dbergl/rv-level-sensor/docs/superpowers/plans/2026-11-01-ac-bridge.md

# AC Bridge Implementation Plan

> **For agentic workers:** REQUIRED SUB-SKILL: Use superpowers:subagent-driven-development (recommended) or superpowers:executing-plans to implement this plan task-by-task. Steps use checkbox (`- [ ]`) syntax for tracking.

**Goal:** The ESP32 leveling sensor also becomes the Firefly panel's RV-C AC (instance 7), bridging to the CountryModPro rooftop unit over Bluetooth, with paired Home Assistant control through the `rv_level` integration.

**Architecture:** Host-testable logic in `lib/` (unit protocol, bridge state machine, RV-C thermostat codec and panel glue, pairing/session crypto, HA message codec), thin NimBLE glue in `src/hal/`, wiring in `src/main.cpp` behind two build options. On the HA side, `rv_level` gains a second config-entry kind ("ac") with its own Bluetooth client and the full `countrymodpro` entity set.

**Tech Stack:** ESP32 Arduino + PlatformIO, NimBLE-Arduino 1.4, Unity host tests (`pio test -e native`), monocypher 4.0.2 (already in `lib/`); Home Assistant custom integration (Python 3.14, bleak / bleak-retry-connector via HA's bluetooth, `cryptography`, `hashlib.blake2b`), pytest-homeassistant-custom-component.

**Spec:** `docs/superpowers/specs/2026-11-01-ac-bridge-design.md` (read its Signal sheet before any task; it is the only source of wire facts).

## Global Constraints

- **Clean room:** do not open `countrypro/`, `velit-hass`, `countrymodpro` or the Pi bridge sources. Every byte value comes from the spec's Signal sheet.
- Unit commands are limited to the spec's allow-list; nothing else may ever be written to the unit.
- At least 400 ms between unit commands; a command with no status frame within 3 s has failed.
- Instance 7. Panel status DGNs sent: 1FFE2, 1FF9C, 1FEFA, 0FFA1 (priority 6), on change and at least every 5 s; never 1FFE1.
- Temperatures on RV-C: uint16 LE, 1/32 °C/bit, offset −273 °C, encoded by rounding **up**.
- Setpoint 61–86 °F, whole degrees; refused while the unit is in °C.
- With the AC bridge on, CPU runs at 240 MHz all the time; AC-off builds keep today's 80 MHz behavior.
- AC-off build behaves exactly as today (all existing tests pass unchanged).
- Both build options off must fail to compile.
- HA entity ids and values match today's `countrymodpro` set (spec entity table), except fresh air and dehumid, which are dropped.
- Code style follows this repo (namespaces per lib, `camelCase` methods, trailing-underscore members, terse comments that say why).

## Review Focus

1. **The unit changes on its own mid-command** (someone uses its remote): the reply shows something else. Expected: the reply is the truth, the intent is reported failed if not satisfied, nothing is retried in a loop. Test in Task 3.
2. **Fragment loss or garbage between frames**: expected resync on the next `5A 5A`, no wedged stream, no false frame. Test in Task 2.
3. **A captured HA command is replayed**, in the same or a later connection: expected rejected. Test in Task 6.
4. **Panel commands while the unit is unreachable**: expected nothing queued; after reconnect nothing old is sent, and the panel stays stale. Test in Tasks 3 and 5.
5. **Setpoint up at 86 °F, down at 61 °F, or heat/dry/unknown panel codes**: expected no command outside 61–86 and no heat/dry command. Test in Task 5.

---

### Task 1: Build options, `countrypro/` ignored, Node without leveling

**Files:**
- Modify: `.gitignore`, `platformio.ini`, `src/config.h`, `src/main.cpp`, `lib/rvc/node.h`, `lib/rvc/node.cpp`
- Test: `test/test_node/test_main.cpp`

**Interfaces:**
- Produces: macros `RVL_LEVELING` and `RVL_AC_BRIDGE` (0/1, default 1), mirrored as `cfg::LEVELING_ENABLED` / `cfg::AC_BRIDGE_ENABLED` (`constexpr bool`); `rvc::NodeConfig::leveling` (`bool`, default `true`); PlatformIO envs `esp32` (both), `esp32_level` (leveling only), `esp32_ac` (AC only).

- [ ] **Step 1:** Add `countrypro/` to `.gitignore`; confirm `git status --short` no longer lists it.
- [ ] **Step 2: Write the failing tests** in `test/test_node/test_main.cpp`:
  - `test_no_leveling_claims_and_answers_product_id`: `NodeConfig c = config(); c.leveling = false;` claim, then a REQUEST for PRODUCT_ID gets the multipacket reply (same assertions as the existing PRODUCT_ID test).
  - `test_no_leveling_sends_no_leveling_dgns`: after claim and 5 s of `update(SensorSnapshot{}, t)` every 10 ms, `bus.count(dgn::LEVELING_SENSOR_STATUS) == 0`, `bus.count(dgn::LEVEL_WHEEL_STATUS) == 0`, `bus.count(dgn::PITCH_CONFIG_STATUS) == 0`, and DM_RV frames exist with no fault (byte 0 lamp bits clear).
  - `test_no_leveling_ignores_config_and_block_commands`: a PITCH_CONFIG_COMMAND and a block config command produce no ACK/NAK and no status.
- [ ] **Step 3:** Run `pio test -e native -f test_node`; expect the three new tests to fail.
- [ ] **Step 4:** Add `bool leveling = true;` to `NodeConfig`. When false, `Node::update` skips status, config-status and wheel sends and reports DM_RV with no fault; `onFrame` skips PROPRIETARY_A2 and pitch/roll config commands; `handleRequest` NAKs leveling DGNs as unknown.
- [ ] **Step 5:** Run `pio test -e native`; expect all tests to pass (existing ones unchanged).
- [ ] **Step 6:** In `src/config.h` add the `#ifndef RVL_LEVELING / #define RVL_LEVELING 1` pair (and `RVL_AC_BRIDGE`), the two `constexpr bool`s, `static_assert(LEVELING_ENABLED || AC_BRIDGE_ENABLED, "enable leveling, the AC bridge, or both")`, and `MODEL` chosen by build: `LEVEL-MPU6050` (leveling only), `AC-COUNTRYMOD` (AC only), `LEVEL-AC` (both). In `platformio.ini` add `esp32_level` (`-DRVL_AC_BRIDGE=0`) and `esp32_ac` (`-DRVL_LEVELING=0`) extending `env:esp32`. In `src/main.cpp` gate MPU init, sampling, `bleReading` and LED out-of-level on `cfg::LEVELING_ENABLED`, and pass `nc.leveling = cfg::LEVELING_ENABLED`.
- [ ] **Step 7:** Run `pio run -e esp32 && pio run -e esp32_level && pio run -e esp32_ac`; all three build. Temporarily build with `-DRVL_LEVELING=0 -DRVL_AC_BRIDGE=0` and confirm the static_assert message, then revert.
- [ ] **Step 8:** Commit: `feat: build options for leveling and the AC bridge`.

---

### Task 2: CountryModPro unit protocol (`lib/countrymod`)

**Files:**
- Create: `lib/countrymod/unit_protocol.h`, `lib/countrymod/unit_protocol.cpp`
- Test: `test/test_unit_protocol/test_main.cpp`

**Interfaces:**
- Produces (namespace `cm`):
  - `constexpr size_t kCommandLen = 9; constexpr size_t kFrameLen = 21;`
  - `bool isAllowed(uint8_t func, uint8_t data);`
  - `bool buildCommand(uint8_t func, uint8_t data, uint8_t out[kCommandLen]);` — false (and `out` untouched) if not allowed.
  - `class FrameAssembler { public: template<class F> void feed(const uint8_t* d, size_t n, F onFrame); uint32_t discarded() const; };` — calls `onFrame(const uint8_t frame[kFrameLen])` for each valid frame.
  - `enum class Mode : uint8_t { Cool, Eco, Sleep, Turbo, FanOnly, Dehumid, Unknown };`
  - `struct UnitStatus { bool power; bool display; bool light; bool oscillating; bool celsius; uint8_t fan; /*0 auto,1-5, 0xFF unknown*/ Mode mode; uint8_t setpointF; /*0xFF unknown*/ uint8_t airTempF; /*0xFF unknown*/ uint8_t setpointRaw; uint8_t batteryV; /*0xFF unknown*/ uint16_t lvpDeciV; uint8_t raw[kFrameLen]; };`
  - `bool decodeStatus(const uint8_t frame[kFrameLen], UnitStatus& out);` — false if checksum/framing bad.
  - `constexpr uint8_t` names for every func and data value in the allow-list (`kFuncPower = 0x01`, `kPowerOn = 0x02`, `kModeCool = 0x01`, … `kFanAuto = 0x06`).

- [ ] **Step 1: Write the failing tests:**
  - `test_build_command_power_on`: `buildCommand(0x01, 0x02, out)` → `5A 5A 06 01 01 02 <ck> 0D 0A` with `ck = (0x5A+0x5A+0x06+0x01+0x01+0x02) & 0xFF = 0xBE`.
  - `test_allow_list`: true for every row of the spec's command table (loop over all listed values, including 61 and 86 setpoints); false for mode `03`, mode `07`, func `44`, setpoint 60 and 87, fan 0 and 7, func `0B`.
  - `test_build_refuses_disallowed`: returns false and leaves `out` unchanged.
  - `test_assembler_10_10_1`: a valid frame fed as 10, 10, 1 bytes yields exactly one frame.
  - `test_assembler_resyncs_after_garbage_and_lost_fragment` (Review Focus 2): feed `FF 00 5A`, then a frame missing its middle 10 bytes, then a full valid frame → exactly one frame (the last), `discarded() > 0`.
  - `test_assembler_split_header`: a frame whose `5A 5A` header is split across two feeds is found.
  - `test_assembler_bad_checksum_rejected`.
  - `test_decode_fields`: build frames from the spec's field table and assert power, display, fan (`(b2>>1)&7`), light, oscillating, celsius (`b16 == 0`), battery (`b8`), `lvpDeciV == 256 + b9`.
  - `test_decode_mode`: b3 `0x10/0x20/0x80` → Sleep/Eco/Turbo; b3 `0x00` with b2 bits `0x30` → FanOnly, `0x20` → Dehumid, `0x00` → Cool; b3 `0x40` (vendor app) treated as `0x00`; b3 `0x30` → Unknown.
  - `test_decode_out_of_range_unknown`: air temp 29 and 131 °F, setpoint 49 and 100 °F, battery 19 and 71 → `0xFF`.
  - `test_decode_celsius_converts`: b16 = 0, b4 = 14, b17 = 18 → `airTempF == 57`, `setpointF == 64`, `setpointRaw == 18`.
- [ ] **Step 2:** Run `pio test -e native -f test_unit_protocol`; fails to compile.
- [ ] **Step 3:** Implement per the signatures (°C → °F is `round(c * 9 / 5 + 32)`).
- [ ] **Step 4:** Run the tests; all pass.
- [ ] **Step 5:** Commit: `feat(ac): CountryModPro unit protocol`.

---

### Task 3: Bridge state machine (`lib/acbridge`)

**Files:**
- Create: `lib/acbridge/bridge.h`, `lib/acbridge/bridge.cpp`
- Test: `test/test_bridge/test_main.cpp`

**Interfaces:**
- Consumes: `cm::buildCommand`, `cm::FrameAssembler`, `cm::decodeStatus`, `cm::UnitStatus`, `cm::Mode` (Task 2).
- Produces (namespace `ac`):
  - `class IUnitLink { public: virtual bool connected() const = 0; virtual bool write(const uint8_t* d, size_t n) = 0; };`
  - `enum class Op : uint8_t { Power, Mode, Fan, Setpoint, StepSetpoint, Display, Oscillate, Light, Celsius };`
  - `struct Intent { Op op; int8_t value; uint32_t tag; };` — `Mode` values are `cm::Mode` (Cool, Eco, Sleep, Turbo, FanOnly only); `Fan` 0 = auto, 1–5; `Setpoint` °F; `StepSetpoint` ±1; bools as 0/1; `tag` is echoed in the result.
  - `enum class Result : uint8_t { Ok = 0, Refused = 1, Unreachable = 2, NotConfirmed = 3, BadAuth = 4 };` (`BadAuth` is used only by Task 9)
  - `class Bridge { public: explicit Bridge(IUnitLink& link); void submit(const Intent& i, uint32_t nowMs); void onNotify(const uint8_t* d, size_t n, uint32_t nowMs); void tick(uint32_t nowMs); bool responding(uint32_t nowMs) const; const cm::UnitStatus& status() const; uint32_t statusVersion() const; bool takeResult(uint32_t& tag, Result& r); };`
  - Constants: `kGapMs = 400`, `kTimeoutMs = 3000`, `kPollMs = 3000`, `kRespondingMs = 10000`, `kMaxPending = 8`.

Behavior (the decisions the tests pin):
- One intent at a time, FIFO, up to `kMaxPending` (submit beyond that → `Refused`). Each intent expands to an ordered command list from the current status; the intent succeeds when the last command's reply status satisfies it, else `NotConfirmed`.
- Expansion: `Power 0` → `01 01`; `Power 1` → `01 02`. `Mode Cool` → `01 02` if off, then `02 01` unless already Cool/Eco/Sleep/Turbo (then no-op `Ok`). `Mode FanOnly` → power on if off, `02 02`. `Mode Eco/Sleep/Turbo` → `Refused` if off; else `02 04/05/06`. `Fan` → `04 0N` / `04 06`. `Setpoint` / `StepSetpoint` → `Refused` if the unit is in °C or the target leaves 61–86; else `03 <F>`. `Display` → `0A 02/01`; `Oscillate` → `45 01/00`; `Light` → `1C 01/02`; `Celsius` → `20 01/02`.
- `StepSetpoint` counts from the pending setpoint target if a setpoint intent is queued or in flight, else from the reported setpoint.
- Every unit reply replaces `status()` and bumps `statusVersion()` only when the decoded fields change.
- Each command gets one retry after a timeout; then the intent fails `NotConfirmed`.
- While idle, a status query `01 00` every `kPollMs`.
- `submit` while `!link.connected()` or `!responding()` → `Unreachable` immediately; on disconnect, every queued intent fails `Unreachable` and the queue empties.
- `responding(now)` = link connected and a valid frame within `kRespondingMs`.

- [ ] **Step 1: Write the failing tests** with a `FakeLink` (records writes, `connected` flag) and a helper that answers a write with a status frame:
  - `test_polls_every_3s_with_400ms_gap`: first write `01 00`; none before 3000 ms after a reply.
  - `test_cool_from_off_powers_on_then_mode`: writes `01 02` then (≥400 ms later) `02 01`; result `Ok` when the reply shows power on, mode cool.
  - `test_cool_while_eco_is_noop`: status eco → `Ok` with no write.
  - `test_preset_while_off_refused`.
  - `test_step_setpoint_counts_from_pending`: reported 70; three `StepSetpoint +1` submitted back-to-back → writes `03 47`, `03 48`, `03 49` (71, 72, 73).
  - `test_setpoint_refused_in_celsius_and_out_of_range`: `celsius` → `Refused`; reported 86 + step up → `Refused`, no write.
  - `test_reply_differs_reports_not_confirmed_without_loop` (Review Focus 1): reply to `02 04` shows mode cool → result `NotConfirmed`, status = reply, exactly one retry write then no more for that intent.
  - `test_timeout_retries_once_then_fails`.
  - `test_unreachable_fails_fast_and_never_replays` (Review Focus 4): disconnected → `Unreachable`; connect, intents queued, disconnect → all `Unreachable`; reconnect → only `01 00` polls written.
  - `test_queue_limit_refuses`.
  - `test_status_version_bumps_only_on_change`.
  - `test_responding_window`: true after a frame, false 10 s later or when disconnected.
- [ ] **Step 2:** Run `pio test -e native -f test_bridge`; fails.
- [ ] **Step 3:** Implement `Bridge` as specified.
- [ ] **Step 4:** Run; all pass.
- [ ] **Step 5:** Commit: `feat(ac): bridge state machine`.

---

### Task 4: RV-C thermostat codec (`lib/rvc`)

**Files:**
- Create: `lib/rvc/thermostat_codec.h`, `lib/rvc/thermostat_codec.cpp`
- Modify: `lib/rvc/dgn.h`
- Test: `test/test_thermostat_codec/test_main.cpp`

**Interfaces:**
- Produces (namespace `rvc`):
  - In `dgn.h`: `THERMOSTAT_STATUS_1 = 0x1FFE2`, `THERMOSTAT_COMMAND_1 = 0x1FEF9`, `THERMOSTAT_STATUS_2 = 0x1FEFA`, `THERMOSTAT_COMMAND_2 = 0x1FEF8`, `THERMOSTAT_AMBIENT_STATUS = 0x1FF9C`, `FIREFLY_AC_OPTIONS = 0x0FFA0`, `FIREFLY_AC_OPTIONS_STATUS = 0x0FFA1`.
  - `uint16_t encodeTempF(int f);` (round-up rule) and `int decodeTempF(uint16_t raw);` (nearest whole °F; caller checks raw < 0xFE00).
  - `struct ThermoStatus { uint8_t instance; uint8_t mode; /*0 off,1 cool,4 fan,6 dehumid*/ uint8_t fanBits; /*0 auto,1 on,3 n/a*/ uint8_t fanRaw; int coolF; /*-1 = n/a*/ };` `void packThermoStatus1(const ThermoStatus& s, uint8_t out[8]);` (heat setpoint `FFFF`, schedule bits `11`, byte 7 `FF`)
  - `void packAmbient(uint8_t instance, int f, uint8_t out[8]);`
  - `enum class Preset : uint8_t { None, Eco, Sleep, Turbo };` `void packThermoStatus2(uint8_t instance, bool on, Preset p, uint8_t out[8]);` (`on == false` → all `FF` after byte 0)
  - `void packOptionsStatus(uint8_t instance, bool oscillate, bool display, uint8_t out[8]);` (bits 4–7 `1111`)
  - `struct ThermoCommand1 { uint8_t instance; uint8_t mode; /*0x0F = none*/ uint8_t fanBits; uint8_t fanRaw; uint16_t coolRaw; };` `ThermoCommand1 unpackThermoCommand1(const uint8_t in[8]);` plus `constexpr uint16_t SETPOINT_UP = 0xFFFA, SETPOINT_DOWN = 0xFFF9;`
  - `struct ThermoCommand2 { uint8_t instance; bool has; uint8_t code; /*low 6 bits*/ };` `ThermoCommand2 unpackThermoCommand2(const uint8_t in[8]);`
  - `struct OptionsCommand { uint8_t instance; uint8_t oscillate; uint8_t display; /*2-bit: 0 off, 1 on/press, 3 none*/ };` `OptionsCommand unpackOptionsCommand(const uint8_t in[8]);`

- [ ] **Step 1: Write the failing tests:**
  - `test_encode_temp_rounds_up`: `encodeTempF(75) == 9501`, and for every F in 40–100, `((encodeTempF(F) - 8736) * 9 / 160 + 32) == F` with integer truncation (panel formula).
  - `test_decode_temp`: `decodeTempF(9501) == 75`, `decodeTempF(encodeTempF(61)) == 61`.
  - `test_pack_status1_cool_fan3_72`: `{7, 1, 1, 0x78, 72}` → `07 D1 78 FF FF <lo hi of encodeTempF(72)> FF` (byte 1 = mode 1 | fanBits 1<<4 | schedule 3<<6).
  - `test_pack_status1_off`: mode 0, fanBits 3, fanRaw 0 → byte 1 `0xF0`, byte 2 `00`.
  - `test_pack_status2`: Sleep → byte 3 `0xC1`; Eco `0xC4`; Turbo `0xD0`; None `0xC0`; off → bytes 1–7 all `FF`.
  - `test_pack_options_status`: oscillate on, display off → byte 1 `0xF1`; both on → `0xF5`.
  - `test_pack_ambient`.
  - `test_unpack_command1`: byte 1 `0xF0` (mode 0) → mode 0; cool → 1; fan button 3 → fanRaw `0x78`; Auto → fanBits 0; setpoint up → `coolRaw == 0xFFFA`.
  - `test_unpack_command2_codes`: byte 2 `0xD0` → code `0x10`; `0xFF` → `has == false`.
  - `test_unpack_options_command`: byte 1 `0xF7` → display 1, oscillate 3; `0xFD` → oscillate 1, display 3.
- [ ] **Step 2:** Run `pio test -e native -f test_thermostat_codec`; fails.
- [ ] **Step 3:** Implement. `encodeTempF(f) = 8736 + ceil((f - 32) * 160 / 9)` in integer math.
- [ ] **Step 4:** Run; all pass.
- [ ] **Step 5:** Commit: `feat(rvc): thermostat and Firefly AC codec`.

---

### Task 5: Panel glue (`lib/rvc/ac_panel`)

**Files:**
- Create: `lib/rvc/ac_panel.h`, `lib/rvc/ac_panel.cpp`
- Test: `test/test_ac_panel/test_main.cpp`

**Interfaces:**
- Consumes: Task 3 `ac::Bridge`, `ac::Intent`, `ac::Op`; Task 4 codec; `rvc::ITransmitter`, `rvc::CanFrame`, `rvc::makeId`, `rvc::parseId`.
- Produces: `class rvc::AcPanel { public: AcPanel(ac::Bridge& b, ITransmitter& tx, uint8_t instance = 7); void onFrame(const CanFrame& f, uint32_t nowMs); void update(bool claimed, uint8_t sa, uint32_t nowMs); };` with `kHeartbeatMs = 5000`, `kTagPanel = 0` (panel intents' tag; their results are discarded).

Behavior:
- `update` sends nothing unless `claimed && bridge.responding(now)`. Then it sends the four status DGNs when `statusVersion()` changed since the last send and at least every `kHeartbeatMs`. Ambient is sent only when `airTempF != 0xFF`.
- Status mapping: power off → mode 0, fanBits 3, fanRaw 0, status2 off. On: Cool/Eco/Sleep/Turbo → mode 1; FanOnly → 4; Dehumid → 6; Unknown → 1. Fan 0 → fanBits 0, fanRaw 0; fan N → fanBits 1, fanRaw `N * 0x28`. Preset from mode. `coolF` = `setpointF` or −1.
- Frames: only byte 0 == instance and SA ≠ own. 1FEF9: mode 0 → `Power 0`; 1 → `Mode Cool`; 4 → `Mode FanOnly`; anything else (2, 3, 5, 6, …) ignored; fanBits 0 → `Fan 0`; else fanRaw ≤ 200 and > 0 → `Fan clamp(round(pct/20), 1, 5)`; coolRaw `FFFA`/`FFF9` → `StepSetpoint ±1`; coolRaw < `0xFE00` → `Setpoint decodeTempF`. 1FEF8: code `00` → `Mode Cool`; `04/01/10` → `Mode Eco/Sleep/Turbo`, or `Mode Cool` when that preset is already active; other codes ignored. 0FFA0: field 1 → toggle from current status; 0 → off; 3 → nothing.

- [ ] **Step 1: Write the failing tests** using `FakeBus` and a real `ac::Bridge` on a `FakeLink` that answers with scripted frames:
  - `test_silent_until_responding`: no frames before the first unit reply; four DGNs after it (and no 1FFE1).
  - `test_heartbeat_5s_and_on_change`.
  - `test_goes_silent_when_unit_lost` (Review Focus 4): disconnect → no further status.
  - `test_status_mapping_eco_fan3_72`: 1FFE2 byte 1 `0xD1`, byte 2 `0x78`; 1FEFA byte 3 `0xC4`.
  - `test_status_off`.
  - `test_panel_cool_fan_setpoint`: frames → bridge writes `02 01`, `04 03`, `03 48`.
  - `test_panel_ignores_heat_dry_and_other_instances` (Review Focus 5): mode 2, mode 6, instance 6 → no writes.
  - `test_panel_setpoint_up_at_86_no_write` (Review Focus 5).
  - `test_panel_preset_toggle`: eco active + eco press → `02 01`.
  - `test_panel_option_toggle`: display on + display press → `0A 01`.
- [ ] **Step 2:** Run `pio test -e native -f test_ac_panel`; fails.
- [ ] **Step 3:** Implement.
- [ ] **Step 4:** Run; all pass.
- [ ] **Step 5:** Commit: `feat(rvc): instance-7 AC for the Firefly panel`.

---

### Task 6: Pairing, session auth and HA message codec (`lib/acbridge`)

**Files:**
- Create: `lib/acbridge/ha_link.h`, `lib/acbridge/ha_link.cpp`, `tools/ac/vectors.py`
- Test: `test/test_ha_link/test_main.cpp`

**Interfaces:**
- Consumes: monocypher (`crypto_x25519_public_key`, `crypto_x25519`, `crypto_blake2b_keyed`, `crypto_verify16`, `crypto_wipe`); Task 2 `cm::UnitStatus`; Task 3 `ac::Intent`, `ac::Result`.
- Produces (namespace `ac`), the wire format both sides implement (copy into `docs/protocol.md` in Task 14):
  - `void derivePairKey(const uint8_t shared[32], const uint8_t haPub[32], const uint8_t espPub[32], uint8_t key[32]);` = BLAKE2b-256 keyed with `shared` over `"RVL-AC-PAIR-v1" ‖ haPub ‖ espPub`.
  - `void commandMac(const uint8_t key[32], const uint8_t nonce[16], uint32_t counter, const uint8_t* body, size_t n, uint8_t mac[16]);` = BLAKE2b-128 keyed with `key` over `"RVL-AC-CMD-v1" ‖ nonce ‖ counter(u32 LE) ‖ body`.
  - `class Session { public: void begin(const uint8_t nonce[16]); bool accept(const uint8_t key[32], const uint8_t* msg, size_t n, const uint8_t*& body, size_t& bodyLen); };` — `msg` = `counter u32 LE ‖ body ‖ mac16`; accepts only a valid MAC and `counter` > last accepted in this session (first must be ≥ 1).
  - `constexpr size_t kStatusLen = 34; void packStatus(const cm::UnitStatus& s, bool responding, uint8_t out[kStatusLen]);` layout: `[0] version 1`, `[1] flags` (bit0 responding, bit1 power, bit2 display, bit3 light, bit4 oscillating, bit5 celsius), `[2] mode` (cm::Mode value), `[3] fan`, `[4] setpointF`, `[5] airTempF`, `[6] batteryV`, `[7..8] lvpDeciV LE`, `[9..29] raw frame`, `[30..33] 0` (reserved).
  - `bool unpackCommand(const uint8_t* body, size_t n, Intent& out);` body = `op u8 ‖ value i8` (op = `ac::Op` value).
  - `void packResult(uint32_t counter, Result r, uint8_t out[5]);`
- `tools/ac/vectors.py` (uv script, `cryptography`): prints fixed test vectors (two fixed X25519 private keys, both publics, shared, pair key; a nonce, counter 1, body `02 00`, MAC) for pasting into the C++ and Python tests.

- [ ] **Step 1:** Write `tools/ac/vectors.py`; run `uv run tools/ac/vectors.py` and keep the output.
- [ ] **Step 2: Write the failing tests** with those vectors:
  - `test_pair_key_matches_vector` (both sides derive the same key from their own private key and the other's public).
  - `test_command_mac_matches_vector`.
  - `test_session_accepts_increasing_counters`.
  - `test_session_rejects_replay_and_bad_mac` (Review Focus 3): same counter twice → false; counter 0 → false; one flipped MAC bit → false; a message accepted in session A is rejected after `begin()` with a new nonce.
  - `test_pack_status_layout` and `test_unpack_command_rejects_unknown_op_and_short_body`.
- [ ] **Step 3:** Run `pio test -e native -f test_ha_link`; fails.
- [ ] **Step 4:** Implement; wipe private keys and shared secrets after use.
- [ ] **Step 5:** Run; all pass.
- [ ] **Step 6:** Commit: `feat(ac): HA pairing, session auth and message codec`.

---

### Task 7: Shared BLE server and advertising

**Files:**
- Create: `src/hal/ble_server.h`, `src/hal/ble_server.cpp`
- Modify: `src/hal/ble_ota.h`, `src/hal/ble_ota.cpp`, `src/hal/ble_bthome.h`, `src/hal/ble_bthome.cpp`, `src/main.cpp`

**Interfaces:**
- Produces: `class BleServer { public: bool begin(BleBthome& adv); NimBLEServer* server(); void addListener(IBleConnListener* l); void setWantConnectable(uint8_t who, bool want); void poll(); };` with `struct IBleConnListener { virtual void onConnect(uint16_t h) = 0; virtual void onDisconnect(uint16_t h) = 0; };` and `who` bits `kWantOta = 1`, `kWantHa = 2`. Advertising is connectable while any bit is set and fewer than `CONFIG_BT_NIMBLE_MAX_CONNECTIONS` links exist; `poll()` (loop task) re-applies after connect/disconnect.
- `BleBthome::begin` gains `const char* serviceUuid` (nullable): when set, the scan response carries it after the name. With leveling off, the advert carries no BTHome readings.
- `BleOta` takes `BleServer&`, registers as a listener, tracks its client as the connection that first writes its control characteristic (NimBLE 1.4 `onWrite(NimBLECharacteristic*, ble_gap_conn_desc*)`), and on window close drops only that connection.

- [ ] **Step 1:** Implement the above; replace `BleOta`'s own `ServerCb` and advertising handling with `BleServer`.
- [ ] **Step 2:** Build all three envs; `pio test -e native` still passes.
- [ ] **Step 3: Bench check** (`BLE_OTA_DISABLED = false` temporarily, leveling-only build): `uv run tools/hwtest/ble_test.py` passes; open the update window and run a firmware update with the existing tool; confirm it still works. Revert the flag.
- [ ] **Step 4:** Commit: `refactor(ble): shared server for the update and AC services`.

---

### Task 8: Unit link, binding and console commands

**Files:**
- Create: `src/hal/ble_unit_link.h`, `src/hal/ble_unit_link.cpp`
- Modify: `src/hal/nvs_store.h`, `src/hal/nvs_store.cpp`, `src/main.cpp`, `src/config.h`

**Interfaces:**
- Consumes: `ac::IUnitLink`, `ac::Bridge` (Task 3); `rvc::AcPanel` (Task 5).
- Produces:
  - `class BleUnitLink : public ac::IUnitLink { public: void begin(ac::Bridge& b); void bindTo(const NimBLEAddress& a); void forget(); bool bound() const; void startBindScan(uint32_t nowMs); void poll(uint32_t nowMs); bool connected() const override; bool write(const uint8_t* d, size_t n) override; };` — connects only to the bound address, discovers `ffe0`, subscribes `ffe1` (notifications → `bridge.onNotify` on the loop task via a small lock-protected byte queue), writes `ffe2` with response, reconnects with backoff 1 s doubling to 30 s. `startBindScan` scans 10 s for names starting `KT` and binds the strongest RSSI if nothing is bound; logs the chosen name and address.
  - `NvsStore`: `bool loadUnitAddress(uint8_t addr[6], uint8_t& type); void saveUnitAddress(const uint8_t addr[6], uint8_t type); void clearUnitAddress(); bool loadHaKey(uint8_t key[32]); void saveHaKey(const uint8_t key[32]); void clearHaKey();`
  - Pairing window: `cfg::PAIR_WINDOW_MS = 120000`. Opened by the console command `pair`, and automatically at boot when neither a unit nor an HA key is stored. Opening it starts the bind scan (if unbound) and lets the HA service accept pairing (Task 9). Console `forget-ac` clears the unit address; `unpair` clears the HA key.
  - With `cfg::AC_BRIDGE_ENABLED`: `setCpuFrequencyMhz(240)` at boot and never lowered; `main.cpp` calls `bridge.tick`, `unitLink.poll`, `acPanel.onFrame` for every CAN frame and `acPanel.update(node->claimed(), node->address(), now)` each loop.
- [ ] **Step 1:** Implement.
- [ ] **Step 2:** Build all three envs; `pio test -e native` passes.
- [ ] **Step 3: Bench check** with the unit (Pi `virtual-ac` stopped, `countrymodpro` disabled): `pair` binds the `KT…` unit (logged); serial summary shows decoded status every few seconds; `candump -ta can0` shows 1FFE2/1FF9C/1FEFA/0FFA1 from the node's address at ≤ 5 s; each panel button changes the unit and the panel follows; changing the unit at its own remote reaches the panel; pulling the unit's power stops instance-7 frames.
- [ ] **Step 4:** Capture what the panel sends for power and cool while the AC shows off (`candump`), record it in the spec's Signal sheet B, and adjust Task 5's mapping and tests if it differs from mode 1 / mode 0.
- [ ] **Step 5:** Commit: `feat(ac): Bluetooth link to the CountryModPro and pairing window`.

---

### Task 9: HA control service on the ESP32

**Files:**
- Create: `src/hal/ble_ha_service.h`, `src/hal/ble_ha_service.cpp`
- Modify: `src/main.cpp`

**Interfaces:**
- Consumes: `BleServer` (Task 7), `ac::Session`, `derivePairKey`, `packStatus`, `unpackCommand`, `packResult` (Task 6), `ac::Bridge` (Task 3), `NvsStore` key functions (Task 8).
- Produces: GATT service `af480101-29e2-47f0-a341-4f1a49271bf4` with characteristics:
  - `…0102…` **auth** (WRITE | NOTIFY): HA writes `01 ‖ haPub32` to pair (only while the pairing window is open; replies `01 ‖ espPub32`, stores the key, closes the window; otherwise replies `01` alone = refused). HA writes `02` to start a session; reply `02 ‖ nonce16` (fresh random per write, `esp_fill_random`).
  - `…0103…` **status** (NOTIFY | READ): `packStatus` output, notified on `statusVersion()` or `responding` change and every 5 s, to an authenticated session only (reads before auth return empty).
  - `…0104…` **command** (WRITE | NOTIFY): `counter ‖ body ‖ mac`; rejected messages notify `packResult(counter, BadAuth)`; accepted ones submit an `Intent` tagged with the counter, and the bridge result is notified with `packResult`.
  - `setWantConnectable(kWantHa, true)` while no HA session is connected.
- [ ] **Step 1:** Implement.
- [ ] **Step 2:** Build all three envs; `pio test -e native` passes.
- [ ] **Step 3: Bench check** with `tools/ac/ha_client.py` (create it: uv script with `bleak` + `cryptography`, subcommands `pair`, `status`, `cmd <op> <value>`, key in a local file): pair during the window, read status, run each op, confirm a replayed command gets `BadAuth`, confirm pairing is refused outside the window.
- [ ] **Step 4:** Commit: `feat(ac): paired Home Assistant control service`.

---

### Task 10: HA protocol module

**Files:**
- Create: `custom_components/rv_level/ac_protocol.py`
- Test: `tests/test_ac_protocol.py`

**Interfaces:**
- Produces: `SERVICE_UUID`, `AUTH_UUID`, `STATUS_UUID`, `COMMAND_UUID`; `class Op(IntEnum)` (same values as `ac::Op`); `class Mode(IntEnum)` (same as `cm::Mode`); `class Result(IntEnum)`; `@dataclass(frozen=True) class AcStatus` (responding, power, display, light, oscillating, celsius, mode: Mode, fan: int | None, setpoint_f: int | None, air_temp_f: int | None, battery_v: int | None, low_voltage_protection: float, raw: bytes); `def unpack_status(data: bytes) -> AcStatus`; `def pair_key(private: X25519PrivateKey, esp_pub: bytes) -> bytes`; `def command_message(key: bytes, nonce: bytes, counter: int, op: Op, value: int) -> bytes`; `def unpack_result(data: bytes) -> tuple[int, Result]`.
- [ ] **Step 1: Write failing tests** with Task 6's vectors: `test_pair_key_vector`, `test_command_message_vector`, `test_unpack_status_fields` (0xFF → None; `low_voltage_protection == (256 + b9) / 10`), `test_unpack_result`.
- [ ] **Step 2:** Run `uv run --python 3.14 --with-requirements tests/requirements.txt pytest tests/test_ac_protocol.py`; fails.
- [ ] **Step 3:** Implement (`hashlib.blake2b(digest_size=..., key=...)`, `cryptography` X25519).
- [ ] **Step 4:** Run; pass.
- [ ] **Step 5:** Commit: `feat(ha): AC bridge protocol`.

---

### Task 11: HA AC client and runtime

**Files:**
- Create: `custom_components/rv_level/ac_client.py`, `custom_components/rv_level/ac_runtime.py`
- Test: `tests/test_ac_runtime.py`

**Interfaces:**
- Consumes: Task 10.
- Produces: `class AcClient` (bleak via `bleak_retry_connector.establish_connection` and `homeassistant.components.bluetooth.async_ble_device_from_address`; `async connect()`, `async disconnect()`, `async start_session() -> None`, `async send(op: Op, value: int) -> Result` (counter increments per message, waits up to 15 s for the matching result), status callback); `class AcRuntime` (`async_start`, `async_stop`, `status: AcStatus | None`, `available: bool` (HA ↔ ESP32 link up and session open), `async_add_listener`, `async command(op, value)` raising `HomeAssistantError` with the result name on anything but `Ok`); reconnect with backoff 1 s → 60 s.
- [ ] **Step 1: Write failing tests** with a fake `AcClient`: status update notifies listeners; disconnect sets `available` False and schedules reconnect; `command` raises on `Refused`/`Unreachable`/`NotConfirmed`/`BadAuth`; counter never repeats across reconnects within a session object (new session → new nonce).
- [ ] **Step 2:** Run; fails.
- [ ] **Step 3:** Implement.
- [ ] **Step 4:** Run; pass.
- [ ] **Step 5:** Commit: `feat(ha): AC client and runtime`.

---

### Task 12: HA config flow with entry kinds and pairing

**Files:**
- Modify: `custom_components/rv_level/manifest.json`, `const.py`, `__init__.py`, `config_flow.py`, `strings.json`, `translations/en.json`, `migrate.py`
- Test: `tests/test_config_flow.py`, `tests/test_ac_config_flow.py`

**Interfaces:**
- Produces: `CONF_KIND = "kind"`, `KIND_LEVELING = "leveling"`, `KIND_AC = "ac"`, `CONF_KEY = "key"` (hex). Entries without `kind` are leveling (config entry `VERSION` 2 with a migration that adds `kind: leveling`).
- `manifest.json`: drop `single_config_entry`; add `"bluetooth": [{"service_uuid": "af480101-29e2-47f0-a341-4f1a49271bf4", "connectable": true}]`; add `"bluetooth"` to `dependencies`; bump `version` to `0.2.0`.
- Flow: `async_step_user` shows a menu (`leveling`, `ac`). Leveling path unchanged but aborts `already_configured` if a leveling entry exists. AC path: `async_step_bluetooth` (discovery) or a picker of discovered addresses, then `async_step_pair` (form text: "Type `pair` on the sensor's console, or power-cycle an unpaired sensor, then submit") which runs the auth exchange and creates `{kind: ac, address, key}` with `unique_id = f"ac_{address}"`. Pairing refused → form error `pair_refused`; not reachable → `cannot_connect`.
- `__init__.py` dispatches on kind: leveling → today's setup; ac → `AcRuntime` and platforms `CLIMATE, SWITCH, SELECT, NUMBER, SENSOR, BINARY_SENSOR`. The dashboard is set up only for leveling entries.
- [ ] **Step 1: Write failing tests:** existing config-flow tests updated to pass through the menu; `test_second_leveling_entry_aborts`; `test_ac_pair_creates_entry` (fake client returns ESP pub); `test_ac_pair_refused_shows_error`; `test_ac_only_without_leveling_device`; `test_migrate_v1_entry_gets_kind_leveling`.
- [ ] **Step 2:** Run the integration test suite; new tests fail.
- [ ] **Step 3:** Implement.
- [ ] **Step 4:** Run the whole suite; all pass.
- [ ] **Step 5:** Commit: `feat(ha): add the AC as a second entry kind with pairing`.

---

### Task 13: HA AC entities

**Files:**
- Create: `custom_components/rv_level/climate.py`, `switch.py`, `select.py`, `ac_entity.py`
- Modify: `sensor.py`, `binary_sensor.py`, `number.py`, `strings.json`, `translations/en.json`, `icons.json`
- Test: `tests/test_ac_entities.py`

**Interfaces:**
- Consumes: `AcRuntime` (Task 11), `ac_protocol.Op/Mode` (Task 10).
- Produces: device named `CountryModPro` (manufacturer `CountryModPro`, model `Rooftop AC`, `via_device` none) with `has_entity_name = True` and translation names chosen so entity ids are exactly: `climate.countrymodpro` (name None), `switch.countrymodpro_power`, `binary_sensor.countrymodpro_power`, `select.countrymodpro_operating_mode`, `sensor.countrymodpro_mode`, `select.countrymodpro_fan_level`, `number.countrymodpro_setpoint`, `sensor.countrymodpro_air_temperature`, `sensor.countrymodpro_battery_voltage`, `sensor.countrymodpro_low_voltage_protection` (diagnostic), `sensor.countrymodpro_status_frame` (diagnostic, hex with spaces), `switch.countrymodpro_display_in_celsius`, `switch.countrymodpro_light`, `switch.countrymodpro_display`, `switch.countrymodpro_vent_oscillation`, `binary_sensor.countrymodpro_ac_responding` (connectivity), `binary_sensor.countrymodpro_unit_in_celsius` (problem).
- Values: climate hvac modes `off`, `cool`, `fan_only`; presets `none`, `eco`, `sleep`, `boost`; fan modes `auto`, `1`–`5`; min 61, max 86, step 1, °F; `current_temperature` = air temp. Select operating mode options `cool`, `eco`, `sleep`, `turbo`, `fan_only`; fan level `auto`, `1`–`5`. Every control entity (not `ac_responding`) is unavailable when `runtime.available` is False; values are None while `status.responding` is False.
- Mapping to ops: hvac `off` → `Power 0`; `cool` → `Mode Cool`; `fan_only` → `Mode FanOnly`; preset `none` → `Mode Cool`, `eco/sleep/boost` → `Mode Eco/Sleep/Turbo`; fan `auto` → `Fan 0`; setpoint → `Setpoint`; switches → their ops.
- [ ] **Step 1: Write failing tests:** `test_entity_ids_match_countrymodpro` (registry ids exactly as above); `test_climate_state_from_status` (eco → hvac cool, preset eco; fan 3 → "3"); `test_climate_commands_map_to_ops` (each service call → expected `(op, value)` on the fake runtime); `test_unavailable_when_link_down`; `test_unknown_when_unit_not_responding`; `test_unit_in_celsius_problem`.
- [ ] **Step 2:** Run; fails.
- [ ] **Step 3:** Implement.
- [ ] **Step 4:** Run the whole suite; pass.
- [ ] **Step 5:** Commit: `feat(ha): CountryModPro entities on the AC entry`.

---

### Task 14: Docs and release notes

**Files:**
- Modify: `docs/protocol.md`, `docs/usage.md`, `docs/setup.md`, `docs/development.md`, `README.md`

- [ ] **Step 1:** `protocol.md`: instance-7 DGNs (sent and received, field tables from the Signal sheet), the unit link summary, and the HA control service (UUIDs, auth, status, command and result formats, crypto constructions from Task 6).
- [ ] **Step 2:** `usage.md`: pairing (`pair`, `unpair`, `forget-ac`, auto window at first boot), adding the AC in HA, the cut-over order from the spec, a pet-mode alert example automation using `binary_sensor.countrymodpro_ac_responding` and the AC device's availability.
- [ ] **Step 3:** `setup.md` and `development.md`: the three envs, the 240 MHz note with the measured current (measure at the bench: leveling-only vs both), new tests and `tools/ac/`.
- [ ] **Step 4:** README summary line for the AC bridge.
- [ ] **Step 5:** Commit: `docs: AC bridge`.
