dbergl/rv-level-sensor/case/level_case_lid.stl

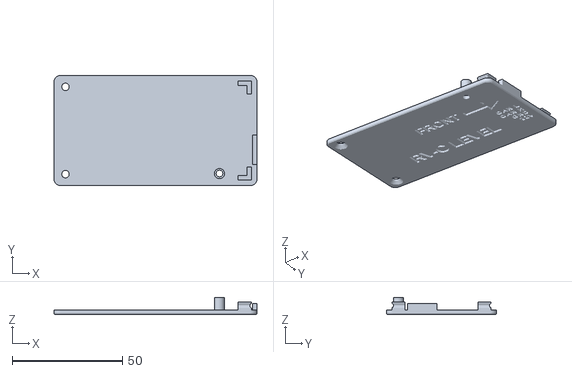
[picture p1: CAD file, 2026-10-08]
case/level_case_lid.stl
92.0 x 50.0 x 7.80
