dbergl/rv-level-sensor/case/level_case_bottom.stl

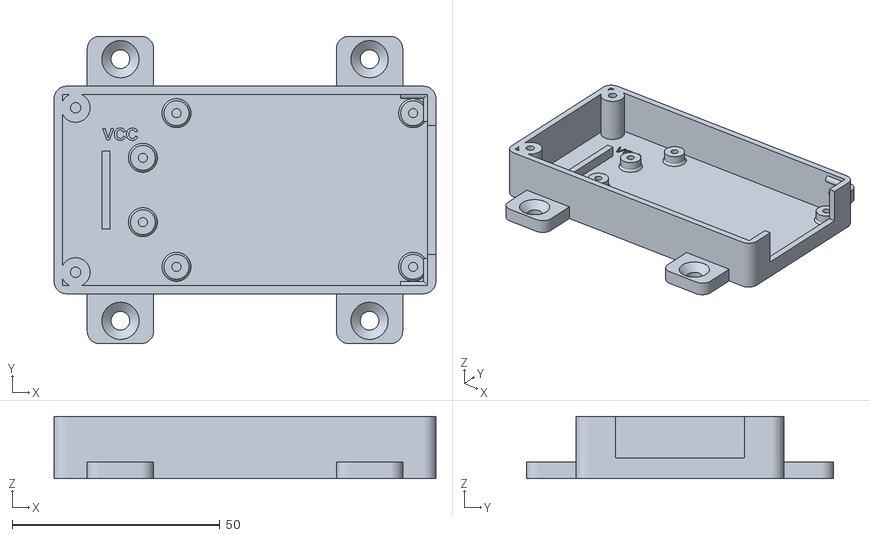
[picture p2: CAD file, 2026-10-08]
case/level_case_bottom.stl
92.0 x 74.0 x 15.0
