dbergl/rv-level-sensor/case/level_case.stl

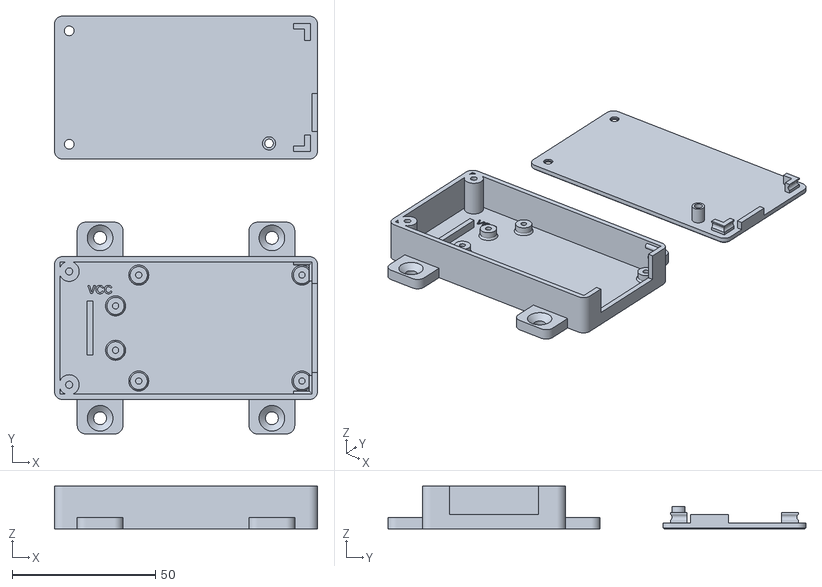
[picture p3: CAD file, 2026-10-08]
case/level_case.stl
92.0 x 146.0 x 15.0
