dbergl/rv-level-sensor/src/hal/ble_ota.cpp

#include "hal/ble_ota.h"

#include <Arduino.h>
#include <NimBLEDevice.h>

#include <cstring>

#include "hal/ota_flash.h"
#include "ota_pubkey.h"

namespace {

constexpr const char* kServiceUuid = "af480001-29e2-47f0-a341-4f1a49271bf4";
constexpr const char* kInfoUuid = "af480002-29e2-47f0-a341-4f1a49271bf4";
constexpr const char* kControlUuid = "af480003-29e2-47f0-a341-4f1a49271bf4";
constexpr const char* kDataUuid = "af480004-29e2-47f0-a341-4f1a49271bf4";
constexpr size_t kVersionMax = 40;

class ControlCb : public NimBLECharacteristicCallbacks {
 public:
  explicit ControlCb(BleOta& o) : o_(o) {}
  void onWrite(NimBLECharacteristic* c, ble_gap_conn_desc* desc) override {
    NimBLEAttValue v = c->getValue();
    o_.onControlWrite(desc->conn_handle, v.data(), v.length());
  }

 private:
  BleOta& o_;
};

class DataCb : public NimBLECharacteristicCallbacks {
 public:
  explicit DataCb(BleOta& o) : o_(o) {}
  void onWrite(NimBLECharacteristic* c, ble_gap_conn_desc* desc) override {
    NimBLEAttValue v = c->getValue();
    o_.onDataWrite(desc->conn_handle, v.data(), v.length());
  }

 private:
  BleOta& o_;
};

class InfoCb : public NimBLECharacteristicCallbacks {
 public:
  explicit InfoCb(BleOta& o) : o_(o) {}
  void onRead(NimBLECharacteristic*) override { o_.onInfoRead(); }

 private:
  BleOta& o_;
};

}  // namespace

BleOta::BleOta(OtaFlash& flash, BleServer& server, const char* version)
    : server_(server), version_(version), session_(flash, kOtaPublicKey) {}

bool BleOta::begin() {
  mu_ = xSemaphoreCreateMutex();
  if (mu_ == nullptr) return false;
  if (server_.server() == nullptr) return false;
  server_.addListener(this);
  NimBLEService* svc = server_.server()->createService(kServiceUuid);
  info_ = svc->createCharacteristic(kInfoUuid, NIMBLE_PROPERTY::READ);
  info_->setCallbacks(new InfoCb(*this));
  control_ = svc->createCharacteristic(kControlUuid, NIMBLE_PROPERTY::WRITE | NIMBLE_PROPERTY::NOTIFY);
  control_->setCallbacks(new ControlCb(*this));
  NimBLECharacteristic* data = svc->createCharacteristic(kDataUuid, NIMBLE_PROPERTY::WRITE_NR);
  data->setCallbacks(new DataCb(*this));
  return svc->start();
}

void BleOta::openWindow(uint32_t nowMs) {
  Lock l(mu_);
  session_.openWindow(nowMs);
}

void BleOta::poll(uint32_t nowMs) {
  bool open;
  {
    Lock l(mu_);
    session_.tick(nowMs);
    open = session_.windowOpen();
  }
  uint16_t client = client_.load();
  if (open) {
    dropped_ = kNoLink;
  } else if (client != kNoLink && client != dropped_) {
    server_.server()->disconnect(client);
    dropped_ = client;
  }
  server_.setWantConnectable(BleServer::kWantOta, open && client == kNoLink);
}

bool BleOta::rebootDue(uint32_t nowMs) {
  Lock l(mu_);
  return session_.rebootDue(nowMs);
}

bool BleOta::windowOpen() {
  Lock l(mu_);
  return session_.windowOpen();
}

// A link is the update client only once it writes control; it may be Home Assistant's.
void BleOta::onConnect(uint16_t) {}

void BleOta::onDisconnect(uint16_t h) {
  Lock l(mu_);
  if (client_.load() != h) return;
  session_.onDisconnect();
  client_ = kNoLink;
}

void BleOta::notify(const ota::Notice& n) {
  uint8_t b[5];
  ota::packNotice(n, b);
  control_->setValue(b, sizeof b);
  control_->notify();
}

void BleOta::onControlWrite(uint16_t h, const uint8_t* d, size_t len) {
  ota::Notice n;
  {
    Lock l(mu_);
    uint16_t c = client_.load();
    if (c == kNoLink && session_.windowOpen()) {
      client_ = c = h;
      server_.claim(h);
    }
    if (c != kNoLink && c != h) return;  // the session belongs to the client's link
    n = session_.onControl(d, len, millis());
  }
  notify(n);
}

void BleOta::onDataWrite(uint16_t h, const uint8_t* d, size_t len) {
  ota::Notice n;
  bool send;
  {
    Lock l(mu_);
    if (client_.load() != h) return;  // no transfer without a client (BEGIN claims it)
    send = session_.onData(d, len, millis(), n);
  }
  if (send) notify(n);
}

void BleOta::onInfoRead() {
  uint8_t b[4 + kVersionMax];
  uint16_t secs;
  {
    Lock l(mu_);
    secs = session_.secondsLeft(millis());
  }
  b[0] = OtaFlash::runningOnTrial() ? 1 : 0;
  b[1] = OtaFlash::runningSlot();
  b[2] = static_cast<uint8_t>(secs);
  b[3] = static_cast<uint8_t>(secs >> 8);
  size_t n = std::strlen(version_);
  if (n > kVersionMax) n = kVersionMax;
  std::memcpy(b + 4, version_, n);
  info_->setValue(b, 4 + n);
}
