dbergl/rv-level-sensor/(commit log)

2026-10-08 RV-C leveling sensor: firmware, case, Home Assistant package and tools
    Claude-Session: https://claude.ai/code/session_01E3TnXfWbwVGR57mL8z1685
    [level_case.scad, level_case.stl, level_case_bottom.stl, level_case_lid.stl]
2026-10-08 Refuse weak OTA public keys at build time; review fixes
    - tools/ota/ed25519_key.py rejects non-canonical, undecodable and small-order
    keys (Monocypher's check does not); tools/ota_pubkey.py stops the build.
    - Clearer signature/begin hints, check-order test, docs wording, unused import.
    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
    [ed25519_key.py, ota_proto.py, test_ed25519_key.py, test_main.cpp, test_sign.py]
2026-10-08 Add BLE_OTA_DISABLED build option, on by default
    When true the Bluetooth update service is not started: the sensor
    accepts no connections and GENERAL_RESET Reboot/Enter Bootloader
    restarts it instead. Updates are then USB only.
    The build no longer needs an OTA signing key while the option is on:
    tools/ota_pubkey.py reads it from src/config.h and writes an all-zero
    placeholder key that is never used. If the setting can't be found, a
    key is still required.
    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
    [config.h, main.cpp]
2026-10-08 docs: drop Qwiic connector references; the GY-521 wires go to JP2
    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
2026-10-28 feat(ha): find the BTHome sensor and config flow
    Claude-Session: https://claude.ai/code/session_018MUv2MDZYLMQtozESsDiBT
2026-10-28 feat(ha): rv_level sensors, binary sensors and settings
    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
2026-10-30 chore: point the manifest and HACS docs at github.com/dbergl/rv-level-sensor
    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
2026-10-30 fix(ha): find BTHome devices without deprecated registry APIs
    DeviceRegistry.devices lookups and DeviceEntry.config_entries are removed
    in HA 2027.9 and 2027.10. Walk the BTHome config entries instead, and fail
    the tests on any deprecation report from the integration.
    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
2026-10-30 style: American spelling (tire, center, color, leveling...)
    Renames levelling.py to leveling.py. Mushroom's 'grey' icon color value
    is left as is, since Mushroom and Home Assistant spell it that way.
    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
    [level_case.scad]
2026-11-02 fix: no leveling output on GENERAL_RESET when leveling is off
    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
    [test_main.cpp]
2026-11-02 fix(ac): fail queued intents when the unit stops responding
    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
    [test_main.cpp]
2026-11-02 fix(rvc): AC panel TX back-off, no guessed fan/mode, setpoint range check
    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
    [test_main.cpp]
2026-11-02 fix(ble): keep a link slot free so the broadcast never stops
    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
    [ble_bthome.cpp, ble_bthome.h, ble_ota.cpp, ble_ota.h, ble_server.cpp, ble_server.h, test_main.cpp]
2026-11-02 fix(ac): native address order, verify a candidate before binding, one write at a time
    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
    [ble_unit_link.cpp, ble_unit_link.h, main.cpp, test_main.cpp]
2026-11-02 fix(ac): HA session needs a proof of the pairing key
    A key-less 02 bound the session, claimed the link and stopped connectable
    advertising, so anyone in range could lock Home Assistant out. 02 now only
    issues a per-link challenge; 03 || proof (BLAKE2b keyed with the pair key)
    makes a link the session. Notify only subscribed links, check the MTU,
    and cap queued writes per link.
    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
    [ble_ha_service.cpp, ble_ha_service.h, test_main.cpp]
2026-11-02 fix(ha): hide the AC mode and fan while off; preset none only clears a preset
    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
2026-11-02 fix(ac): final expiry for the pairing window, start deadline for HA commands
    - PairWindow moves to lib/acbridge; expiry is final, so a millis() wrap can't reopen it.
    - Pairing needs the link subscribed to Auth, so the key is never stored unseen.
    - Connectable while the pairing window is open even beside a session (re-pairing).
    - HA intents not started within 10 s fail NotConfirmed, unwritten.
    - Garbage °C no longer wraps into a believable °F.
    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
    [ble_ha_service.cpp, ble_ha_service.h, main.cpp, test_main.cpp]
2026-11-14 feat(ac): match the panel signals of the working Pi virtual AC
    - 0FFA1: byte 1 base C0 with Recirc in bits 4-5; bytes 2-3 carry the unit's
    low-voltage protection (u16 LE, 0.1 V) for the panel's A/C SETUP page.
    While off, only Recirc is lit.
    - 0FFA0: decode Recirc (bits 4-5, DF). The unit has no fresh-air damper, so
    the toggle is held on the sensor and reset to on while the AC is off.
    - 1FFE1 AIR_CONDITIONER_STATUS is now sent with the other status frames.
    - 1FFE2/1FFE1: fan speed C8 (100 %) on auto while on.
    - 1FFE0 AIR_CONDITIONER_COMMAND is accepted (output > 0 cool, 0 fan only or off).
    Claude-Session: https://claude.ai/code/se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
    [test_main.cpp]
2026-11-14 fix(ac): 1FFE0 with output 00 and fan "no change" is fan only, not off
    Only a fan speed of 00 together with output 00 powers the unit off. FF in
    byte 4 means no change, so the fan keeps running.
    Claude-Session: https://claude.ai/code/session_018MUv2MAcgsBQJtsaWJESAK
    [test_main.cpp]
